CuriousTech/WiFiWaterbedHeater/README.md

# WiFi Smart Waterbed Heater

Discontinued years ago. Go here: [WiFiWaterbedHeater3](https://github.com/CuriousTech/WiFiWaterbedHeater3)

Original model:  
3D

SSR model:  
Slave2
