CuriousTech/WiFiWaterbedHeater/3D/WBFront.stl

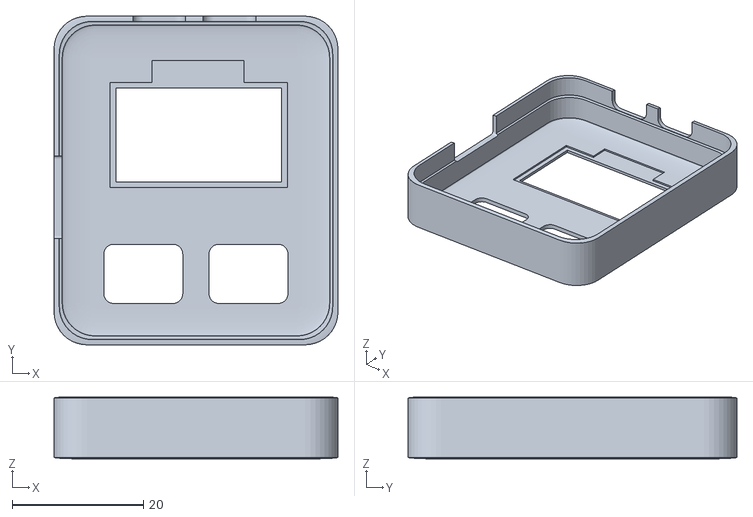
[picture p1: CAD file, 2018-10-15]
3D/WBFront.stl
43.2 x 50.0 x 9.41
