CuriousTech/WiFiWaterbedHeater/3D/WBbutton.stl

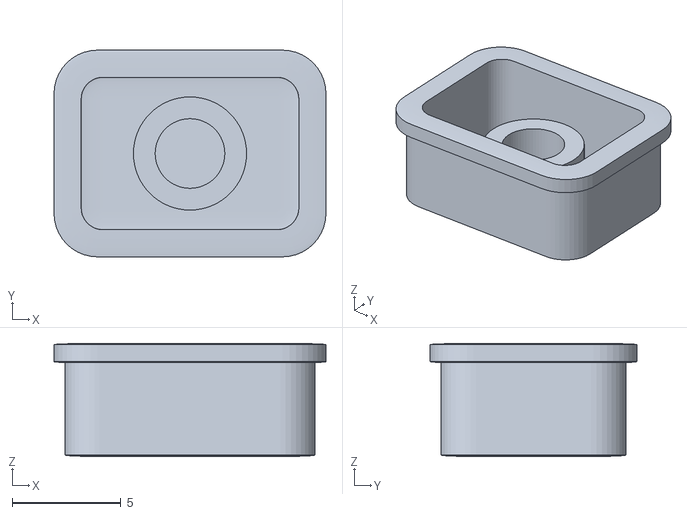
[picture p2: CAD file, 2018-10-15]
3D/WBbutton.stl
12.5 x 9.50 x 5.20
