CuriousTech/WiFiWaterbedHeater/3D/WBBack.stl

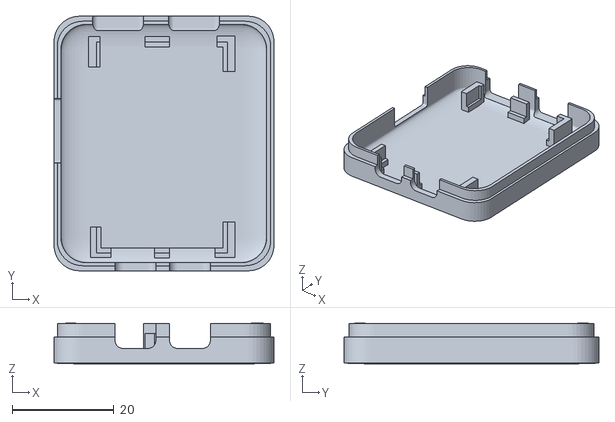
[picture p3: CAD file, 2018-10-13]
3D/WBBack.stl
43.2 x 50.0 x 7.96
