CuriousTech/WiFiWaterbedHeater/3D/Top_btn.stl

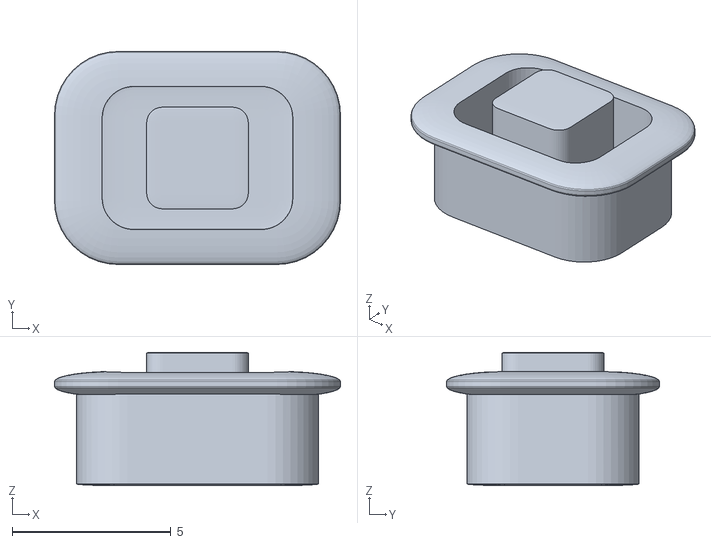
[picture p4: CAD file, 2018-10-13]
3D/Top_btn.stl
9.00 x 6.70 x 4.20
