CuriousTech/WiFiWaterbedHeater/3D/WBSlaveRlyTop.stl

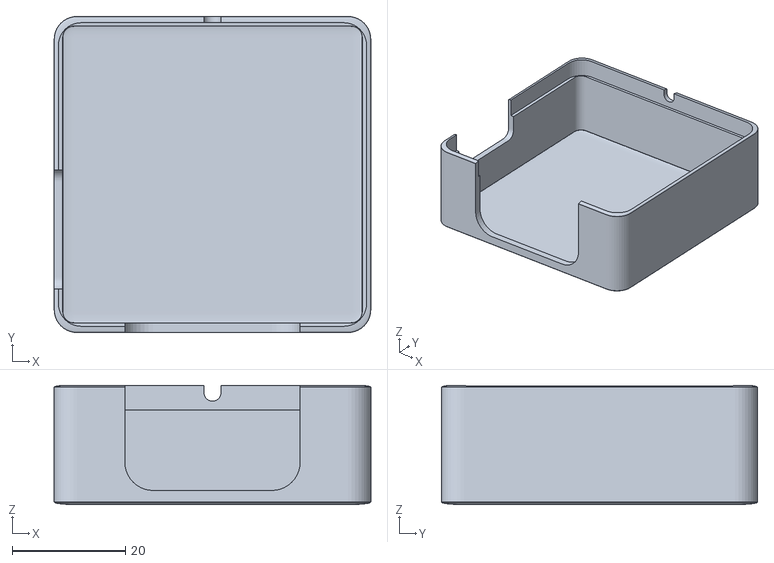
[picture p5: CAD file, 2018-09-26]
3D/WBSlaveRlyTop.stl
56.0 x 55.9 x 21.1
