CuriousTech/WiFiWaterbedHeater/3D/WBSlaveRlyBtm.stl

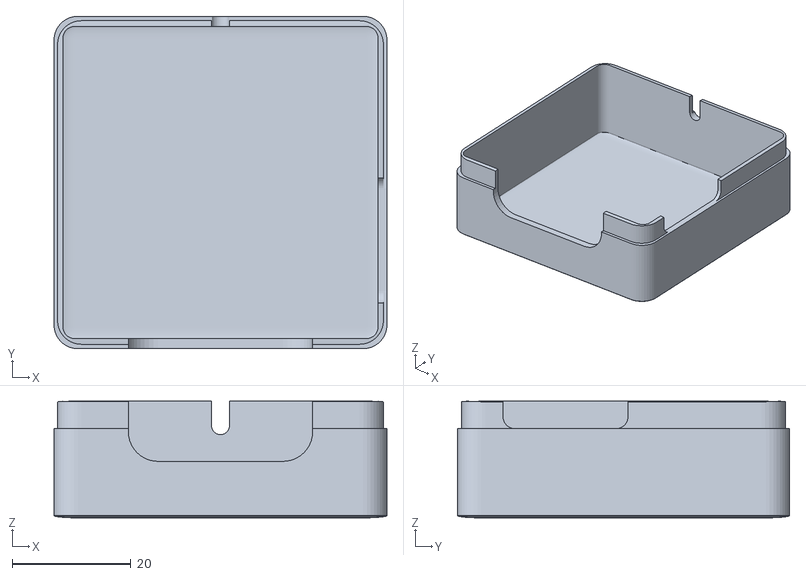
[picture p6: CAD file, 2018-09-26]
3D/WBSlaveRlyBtm.stl
56.0 x 55.9 x 19.6
