CuriousTech/WiFiWaterbedHeater/3D/Slave Bottom.stl

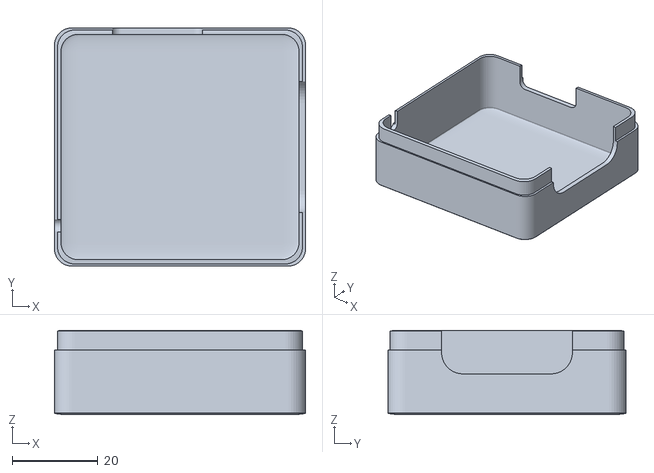
[picture p7: CAD file, 2018-07-28]
3D/Slave Bottom.stl
58.5 x 55.5 x 19.7
