CuriousTech/WiFiWaterbedHeater/3D/Slave Top.stl

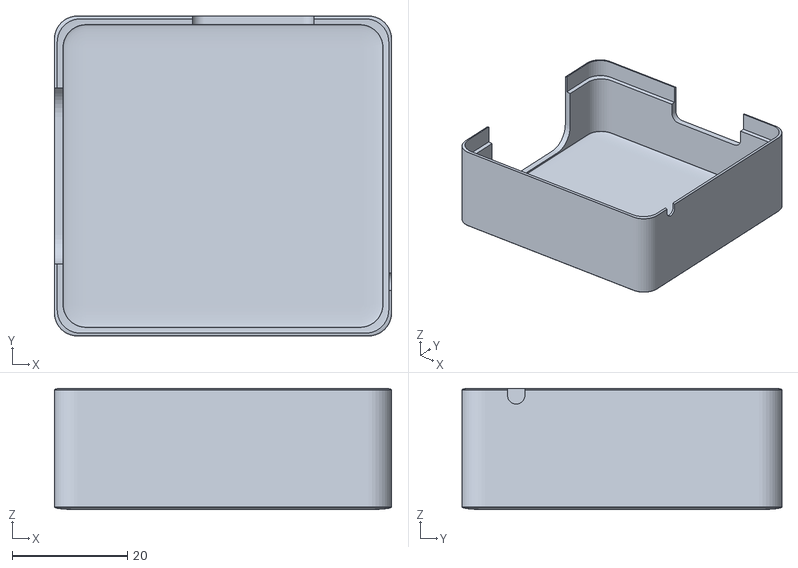
[picture p8: CAD file, 2018-07-28]
3D/Slave Top.stl
58.5 x 55.5 x 21.0
