CuriousTech/WiFiWaterbedHeater/Eagle/HeaterControl.brd

## EAGLE design Eagle/HeaterControl.brd (2018-10-13)

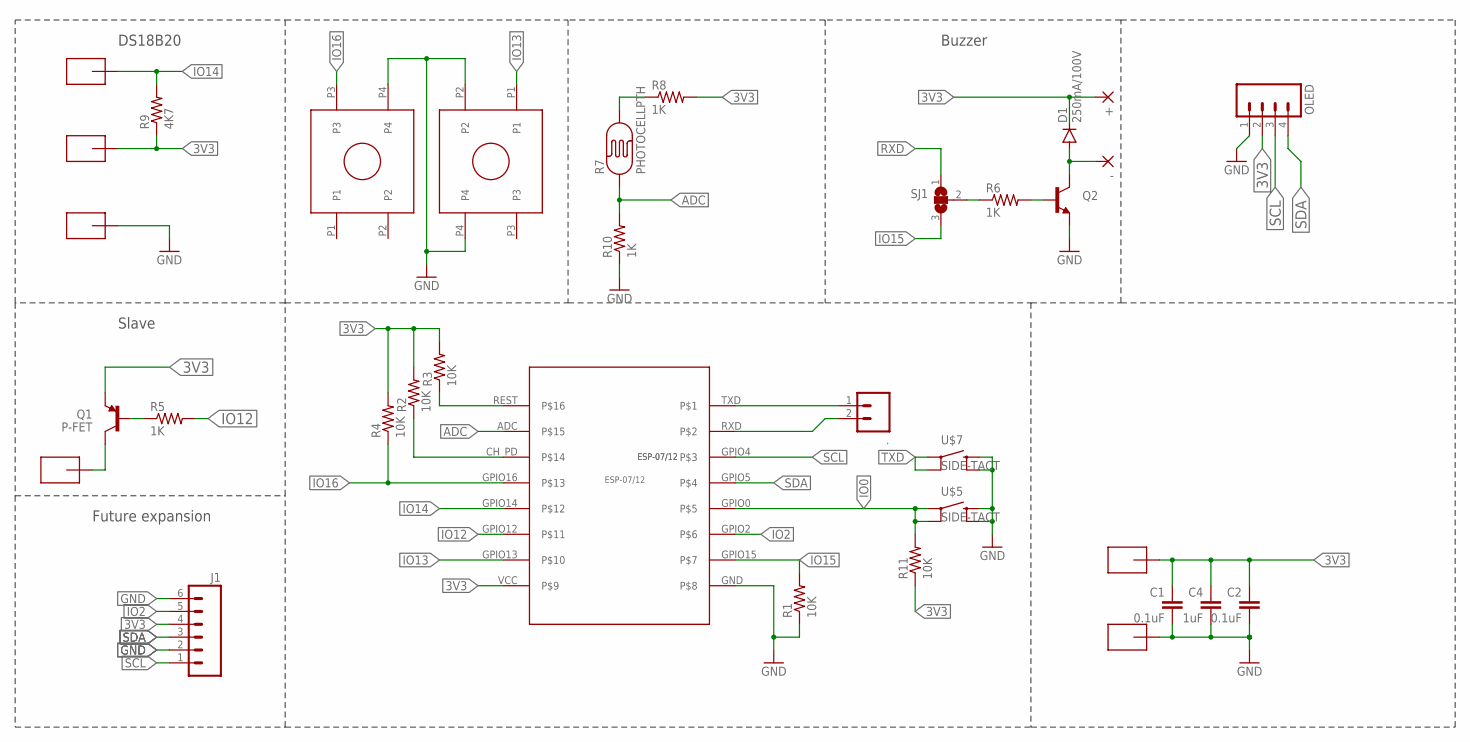
[picture p9: schematic HeaterControl.sch]

Parts:
+: 1,6/0,8
-: 1,6/0,8
.: M02PTH; 1X02
C1, C2: 0.1uF; 0805-CAP
C4: 1uF; 0805-CAP
D1: 250mA/100V; SOD-323
J1: M06SILK_FEMALE_PTH; 1X06
LEFT: OMROM_TH
OLED: M04PTH; 1X04
Q1: P-FET; SOT23-3
Q2: TRANSISTOR_NPNSOT23-3; SOT23-3
R1, R2, R3, R4, R11: 10K; 0805
R5, R6, R8, R10: 1K; 0805
R7: PHOTOCELLPTH; PHOTOCELL
R9: 4K7; 0805
RIGHT: OMROM_TH
SJ1: SJ2W; SJ_2
U$1: ESP-07/12
U$2, U$3, U$6, U$8, U$10, U$11: SMD-PAD1
U$5, U$7: SIDE-TACT

Connections:
3V3: +.1, C1.1, C2.1, C4.1, D1.C, J1.4, OLED.2, Q1.2 (E), R2.2, R3.2, R4.2, R8.2, R9.1, R11.1, U$1.VCC, U$3.>NAME, U$8.>NAME
ADC: R7.1, R10.2, U$1.ADC
GND: C1.2, C2.2, C4.2, J1.2, J1.6, LEFT.P4, OLED.1, Q2.2 (E), R1.1, R10.1, RIGHT.P2, RIGHT.P4, U$1.GND, U$5.3 (2), U$5.4, U$6.>NAME, U$7.3 (2), U$7.4, U$11.>NAME
IO0: R11.2, U$1.GPIO0, U$5.1, U$5.2 (3)
IO2: J1.5, U$1.GPIO2
IO12: R5.2, U$1.GPIO12
IO13: RIGHT.P1, U$1.GPIO13
IO14: R9.2, U$1.GPIO14, U$10.>NAME
IO15: R1.2, SJ1.3, U$1.GPIO15
IO16: LEFT.P3, R4.1, U$1.GPIO16
unnamed: Q1.3 (C), U$2.>NAME
unnamed: Q2.1 (B), R6.2
unnamed: -.1, D1.A, Q2.3 (C)
unnamed: R7.2, R8.1
unnamed: Q1.1 (B), R5.1
unnamed: R6.1, SJ1.2
unnamed: R2.1, U$1.CH_PD
REST: R3.1, U$1.REST
RXD: ..2, SJ1.1, U$1.RXD
SCL: J1.1, OLED.3, U$1.GPIO4
SDA: J1.3, OLED.4, U$1.GPIO5
TXD: ..1, U$1.TXD, U$7.1, U$7.2 (3)

Notes on the sheet:
DS18B20
Slave
Buzzer
Future expansion

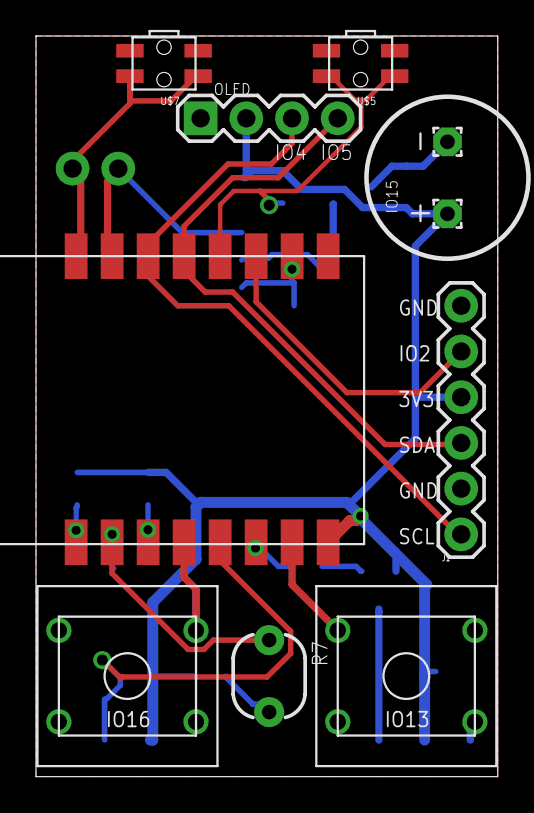
[picture p10: board HeaterControl.brd from above]

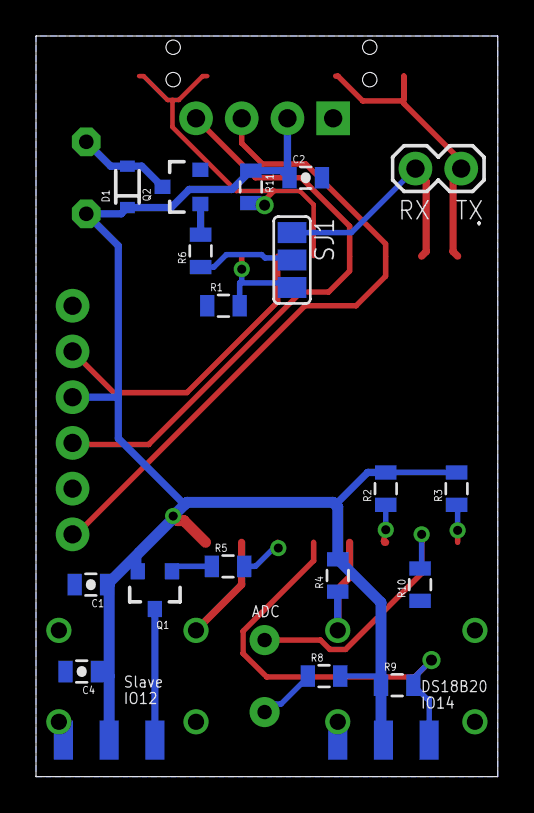
[picture p11: board HeaterControl.brd from below]

Board: 2 copper layers, 25.7 x 41.1 mm, 34 parts (24 on the bottom side), 22 nets.
