CuriousTech/WiFiWaterbedHeater/Slave/WaterbedSlave.brd

## EAGLE design Slave/WaterbedSlave.brd (2018-09-26)

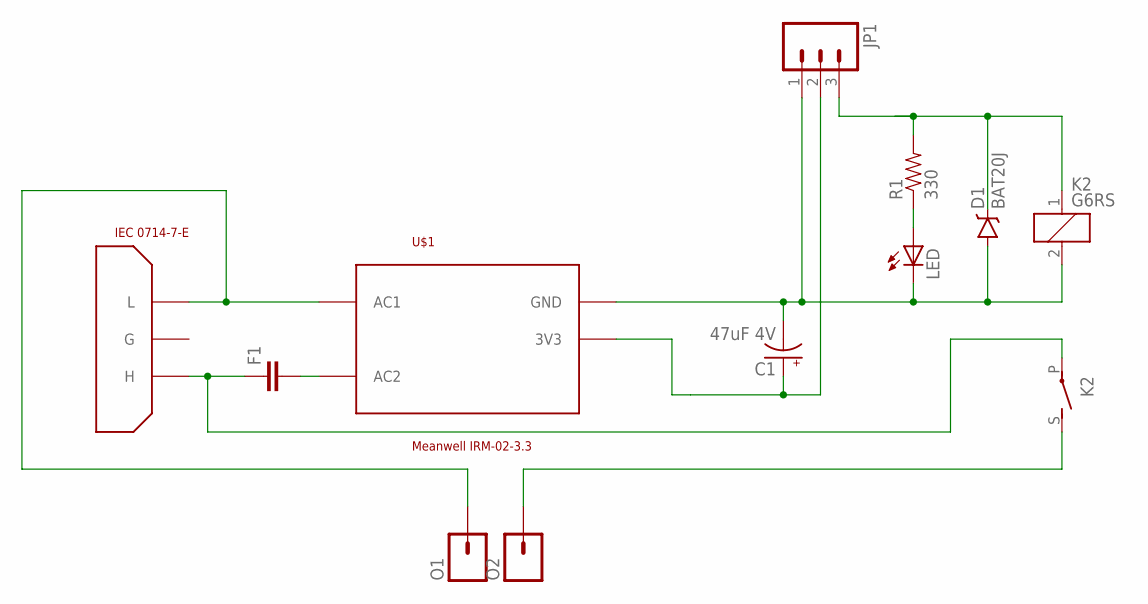
[picture p12: schematic WaterbedSlave.sch]

Parts:
C1: 47uF 4V; CPOL-RADIAL-10UF-25V
D1: BAT20J; SOD-323
F1: CAPPTH1; CAP-PTH-5MM
JP1: M03POLAR_LOCK; MOLEX-1X3_LOCK
K2: G6RS
LED: LEDCHIPLED_0805; CHIPLED_0805
O1, O2: M01PTH_2MM; 1X01_2MM
R1: 330; 0805
U$1: Meanwell IRM-02-3.3; RAC02-3.3SC
U$3: IEC 0714-7-E; IEC

Connections:
3V3: C1.1 (+), JP1.2, U$1.GND (3V3)
GND: C1.2 (-), D1.A, JP1.1, K2.2, LED.C, U$1.3V3 (GND)
unnamed: O1.1, U$1.AC1, U$3.L
unnamed: F1.2, U$1.AC2
unnamed: K2.S, O2.1
unnamed: F1.1, K2.P, U$3.H
unnamed: LED.A, R1.1
unnamed: D1.C, JP1.3, K2.1, R1.2

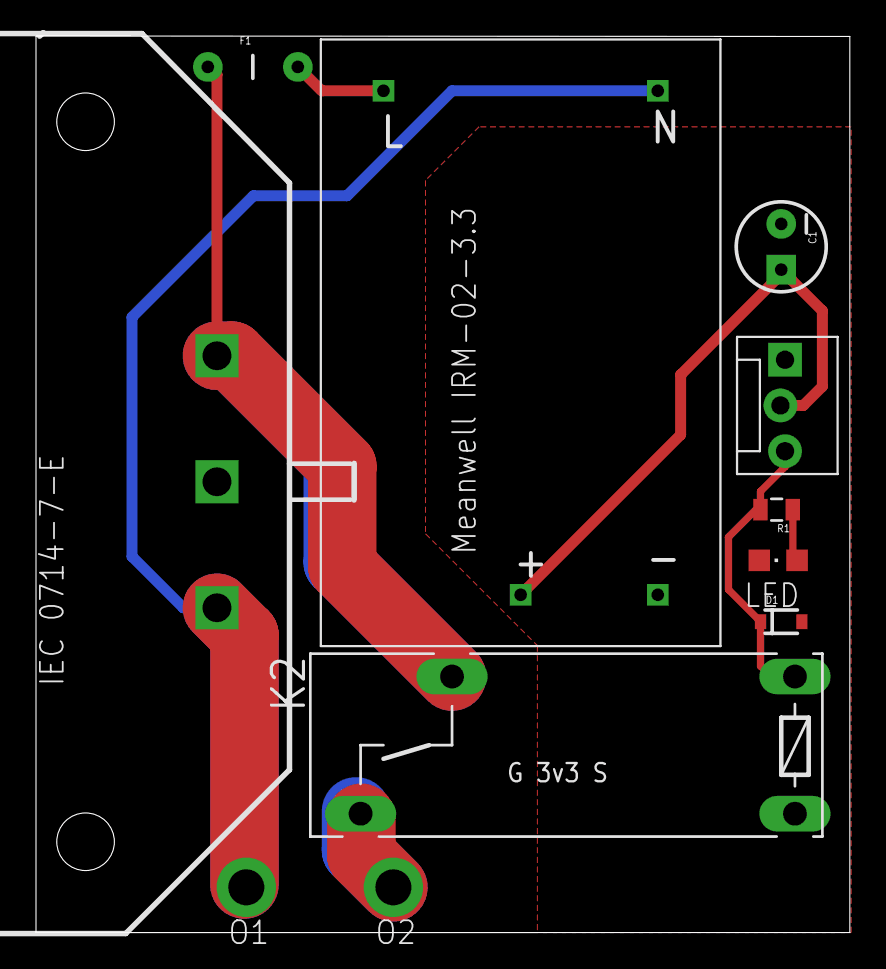
[picture p13: board WaterbedSlave.brd from above]

Board: 2 copper layers, 45.2 x 49.8 mm, 11 parts (0 on the bottom side), 8 nets.
