CuriousTech/WiFiWaterbedHeater/Eagle/HeaterControlPlusPIC.brd

## EAGLE design Eagle/HeaterControlPlusPIC.brd (2015-11-19)

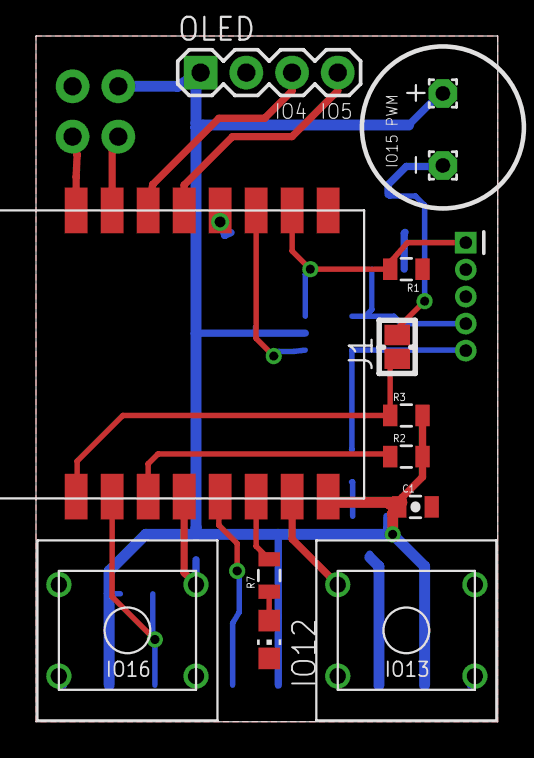
[picture p14: board HeaterControlPlusPIC.brd from above]

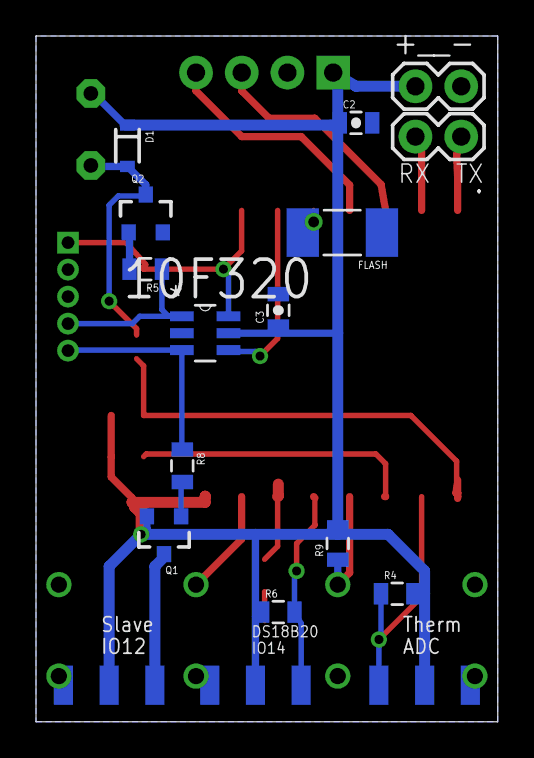
[picture p15: board HeaterControlPlusPIC.brd from below]

Board: 2 copper layers, 25.7 x 38.1 mm, 37 parts (23 on the bottom side), 23 nets.

Parts:
10F320: PIC10F320T-I/OT; SOT95P270X145-6N
+: 1,6/0,8
+__-: 1X02
-: 1,6/0,8
.: 1X02
C1, C2, C3: 0.1uF; 0805-CAP
D1: 250mA/100V; SOD-323
FLASH: BTN_4MM
IO12: CHIP-LED0805
J1: JUMPER_SOLDER_1X2
LEFT: OMROM_TH
OLED: 1X04
Q1: P-FET; SOT23-3
Q2: SOT23-3
R1, R2, R3, R4, R8, R9: 10K; 0805
R5: 1K; 0805
R6: 4K7; 0805
R7: 330; 0805
RIGHT: OMROM_TH
U$1: ESP-07/12
U$2, U$3, U$4, U$5, U$6, U$7, U$8, U$10, U$11: SMD-PAD1
U$9: PIC-ICSP-MINI

Connections:
3V3: 10F320.5, +.1, +__-.1, C1.1, C2.1, C3.1, D1.C, OLED.1, Q1.2, R2.2, R3.2, R4.2, R6.1, R9.2, U$1.VCC, U$3.>NAME, U$4.>NAME, U$8.>NAME
ADC: R4.1, U$1.ADC, U$7.>NAME
GND: 10F320.2, +__-.2, C1.2, C2.2, C3.2, FLASH.1, IO12.C, LEFT.P2, LEFT.P4, OLED.2, Q2.2, R1.1, RIGHT.P2, RIGHT.P4, U$1.GND, U$5.>NAME, U$6.>NAME, U$9.3, U$11.>NAME
HEAT: Q1.1, R8.2
ICSPCLK: 10F320.3, R8.1, U$9.5
IO0: FLASH.2, U$1.GPIO0
IO2: 10F320.4, U$1.GPIO2
IO12: R7.2, U$1.GPIO12
IO13: RIGHT.P1, U$1.GPIO13
IO14: R6.2, U$1.GPIO14, U$10.>NAME
IO15: 10F320.6, R1.2, U$1.GPIO15, U$9.1
IO16: LEFT.P3, R9.1, U$1.GPIO16
unnamed: Q1.3, U$2.>NAME
unnamed: Q2.1, R5.2
unnamed: OLED.3, U$1.GPIO4
unnamed: -.1, D1.A, J1.2, Q2.3
unnamed: IO12.A, R7.1
unnamed: OLED.4, U$1.GPIO5
unnamed: R2.1, U$1.CH_PD
PICPWM: 10F320.1, R5.1, U$9.4
REST: J1.1, R3.1, U$1.REST
RXD: ..2, U$1.RXD
TXD: ..1, U$1.TXD
