CuriousTech/WiFiWaterbedHeater/Adruino/WiFiHeater.ino

/**The MIT License (MIT)

Copyright (c) 2016 by Greg Cunningham, CuriousTech

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
THE SOFTWARE IS PROVIDED "AS IS", WITHOUT WARRANTY OF ANY KIND, EXPRESS OR
IMPLIED, INCLUDING BUT NOT LIMITED TO THE WARRANTIES OF MERCHANTABILITY,
FITNESS FOR A PARTICULAR PURPOSE AND NONINFRINGEMENT. IN NO EVENT SHALL THE
AUTHORS OR COPYRIGHT HOLDERS BE LIABLE FOR ANY CLAIM, DAMAGES OR OTHER
LIABILITY, WHETHER IN AN ACTION OF CONTRACT, TORT OR OTHERWISE, ARISING FROM,
OUT OF OR IN CONNECTION WITH THE SOFTWARE OR THE USE OR OTHER DEALINGS IN THE
SOFTWARE.
*/

#define SDEBUG
//uncomment to enable Arduino IDE Over The Air update code
#define OTA_ENABLE
//#define USE_SPIFFS

#include <Wire.h>
#include <ssd1306_i2c.h> // https://github.com/CuriousTech/WiFi_Doorbell/tree/master/Libraries/ssd1306_i2c
#include <EEPROM.h>
#include <ESP8266mDNS.h>
#include <ESPAsyncWebServer.h> // https://github.com/me-no-dev/ESPAsyncWebServer
#ifdef OTA_ENABLE
#include <FS.h>
#include <ArduinoOTA.h>
#endif
#ifdef USE_SPIFFS
#include <FS.h>
#include <SPIFFSEditor.h>
#else
#include "pages.h"
#endif
#include <OneWire.h>
#include <TimeLib.h> // http://www.pjrc.com/teensy/td_libs_Time.html
#include <UdpTime.h> // https://github.com/CuriousTech/ESP07_WiFiGarageDoor/tree/master/libraries/UdpTime
#include "eeMem.h"
#include "RunningMedian.h"
#include <JsonParse.h> // https://github.com/CuriousTech/ESP8266-HVAC/tree/master/Libraries/JsonParse
#include <AM2320.h> // https://github.com/CuriousTech/ESP8266-HVAC/tree/master/Libraries/AM2320
#include "jsonstring.h"

const char controlPassword[] = "password";    // device password for modifying any settings
const int serverPort = 80;                    // HTTP port
const char hostName[] = "Waterbed";

#define BTN_2     0 // right top
#define BTN_1     1 // left top
//#define MOTION_PIN 3  //
//#define VIBE      2
//#define ESP_LED   2  //Blue LED on ESP07 (on low)
#define SDA       4
#define SCL       5  // OLED and AM2320
#define HEAT     12  // Heater output
#define BTN_UP   13
#define DS18B20  14
#define TONE     15  // Speaker.  Beeps on powerup, but can also be controlled by aother IoT or add an alarm clock.
#define BTN_DN   16

OneWire ds(DS18B20);
byte ds_addr[8];
uint32_t lastIP;
int nWrongPass;

SSD1306 display(0x3C, SDA, SCL); // Initialize the oled display for address 0x3C, SDA=4, SCL=5 (is the OLED mislabelled?)
int displayOnTimer;
AM2320 am;
uint16_t light;
uint32_t nHeatCnt;
uint32_t nCoolCnt;
uint32_t nHeatETA;

bool bConfigDone = false;
bool bStarted = false;
uint32_t connectTimer;

eeMem ee;

AsyncWebServer server( serverPort );
AsyncWebSocket ws("/ws"); // access at ws://[esp ip]/ws

UdpTime utime;

bool bCF = false;
uint16_t roomTemp;
uint16_t rh;

int currentTemp = 860;
int hiTemp; // current target
int loTemp;
bool bHeater = false;
uint8_t schInd = 0;
String sMessage;
uint8_t msgCnt;
uint32_t onCounter;
bool bStartDisplay;
bool bMotion;

int toneFreq = 1000;
int tonePeriod = 100;
int toneCnt;

#ifdef VIBE
int vibePeriod = 200;
int vibeCnt;
#endif

struct tempArr{
  uint16_t min;
  uint16_t temp;
  uint8_t state;
  uint16_t rm;
  uint16_t rh;
};
#define LOG_CNT 98
tempArr tempArray[LOG_CNT];

void jsonCallback(int16_t iName, int iValue, char *psValue);
JsonParse jsonParse(jsonCallback);

const char days[7][4] = {"Sun","Mon","Tue","Wed","Thr","Fri","Sat"};
const char months[12][4] = {"Jan","Feb","Mar","Apr","May","Jun","Jul","Aug","Sep","Oct","Nov","Dec"};

bool updateAll(bool bForce)
{
  return ee.update(bForce);
}

String dataJson()
{
  jsonString js("state");

  js.Var("t", (uint32_t)(now() - ((ee.tz + utime.getDST()) * 3600)) );
  js.Var("waterTemp", String((float)currentTemp/10, 1) );
  js.Var("setTemp", String((float)ee.schedule[schInd].setTemp / 10, 1) );
  js.Var("hiTemp",  String((float)hiTemp/10, 1) );
  js.Var("loTemp",  String((float)loTemp/10, 1) );
  js.Var("on",   (digitalRead(HEAT)==LOW) ? 1:0 );
  js.Var("temp", String((float)roomTemp/10, 1) );
  js.Var("rh",   String((float)rh/10, 1) );
  js.Var("c",    String((bCF) ? "C":"F"));
  js.Var("mot",  bMotion);
  js.Var("eta",  nHeatETA);
  return js.Close();
}

String setJson() // settings
{
  jsonString js("set");

  js.Var("vt", String((float)ee.vacaTemp/10, 1) );
  js.Var("o",   ee.bEnableOLED);
  js.Var("tz",  ee.tz);
  js.Var("avg", ee.bAvg);
  js.Var("ppkwh",ee.ppkwh);
  js.Var("vo",  ee.bVaca);
  js.Var("idx", schInd);
  js.Var("cnt", ee.schedCnt);
  js.Var("w",  ee.watts);
  js.Var("r",  ee.rate);
  js.Var("e",  ee.bEco);
  js.Array("item", ee.schedule, 8);
  ee.tSecsMon[month()-1] += onCounter;
  onCounter = 0;
  js.Array("ts", ee.tSecsMon, 12);
  js.Array("ppkwm", ee.ppkwm, 12);
  return js.Close();
}

void ePrint(const char *s)
{
  jsonString js("print");
  js.Var("data", s);
  ws.textAll(js.Close());
}

void parseParams(AsyncWebServerRequest *request)
{
  char password[64];
  int16_t val;

 if(request->params() == 0)
    return;

  // get password first
  for ( uint8_t i = 0; i < request->params(); i++ ) {
    AsyncWebParameter* p = request->getParam(i);
    String s = request->urlDecode(p->value());

    switch( p->name().charAt(0)  )
    {
      case 'k': // key
        s.toCharArray(password, sizeof(password));
        break;
    }
  }

  uint32_t ip = request->client()->remoteIP();

  if(strcmp(controlPassword, password) || nWrongPass)
  {
    if(nWrongPass == 0)
      nWrongPass = 10;
    else if((nWrongPass & 0xFFFFF000) == 0 ) // time doubles for every high speed wrong password attempt.  Max 1 hour
      nWrongPass <<= 1;
    if(ip != lastIP)  // if different IP drop it down
       nWrongPass = 10;

    jsonString js("hack");
    js.Var("ip", request->client()->remoteIP().toString() );
    js.Var("pass", password);
    ws.textAll(js.Close());
    lastIP = ip;
    return;
  }

  lastIP = ip;

  for ( uint8_t i = 0; i < request->params(); i++ ) {
    AsyncWebParameter* p = request->getParam(i);
    String s = request->urlDecode(p->value());

    int which = p->name().charAt(1) - '0'; // limitation = 9
    if(which >= MAX_SCHED) which = MAX_SCHED - 1; // safety
    val = s.toInt();

    switch( p->name().charAt(0)  )
    {
      case 'm':  // message
        sMessage = s;
        sMessage += " ";
        msgCnt = 4;
        if(ee.bEnableOLED == false)
        {
          bStartDisplay = true;
          displayOnTimer = 60;
        }
        break;
      case 'r': // rate
        if(val == 0)
          break; // don't allow 0
        ee.rate = val;
        sendState();
        break;
      case 'a':
        updateAll(true);
        delay(100);
        ESP.reset();
        break;
      case 'b': // beep : /s?key=pass&b=1000,800,3 (tone or ms,tone,cnt)
        toneCnt = 1;
        {
          int n = s.indexOf(",");
          if(n >0)
          {
            tonePeriod = constrain(val, 10, 1000);
            s.remove(0, n+1);
            val = s.toInt();
          }
          toneFreq = val;
          n = s.indexOf(",");
          if(n >0)
          {
            s.remove(0, n+1);
            toneCnt = constrain(s.toInt(), 1, 20);
          }
        }
        break;
      case 'c': // restore the month's total (in cents) after updates
        break;
      case 'w': // restore the month's total (in watthours) after updates
        break;
#ifdef VIBE
      case 'v': // vibe
        {
          int n = s.indexOf(",");
          if(n >0)
          {
            s.remove(0, n+1);
            vibeCnt = s.toInt();
          }
        }
        vibePeriod = val;
        pinMode(VIBE, OUTPUT);
        digitalWrite(VIBE, LOW);
        break;
#endif
      case 't': // tadj (for room temp)
        ee.tAdj[1] = constrain(val, -200, 200);
        break;
    }
  }
}

String sDec(int t) // just 123 to 12.3 string
{
  String s = String( t / 10 ) + ".";
  s += t % 10;
  return s;
}

// Time in hh:mm[:ss][AM/PM]
String timeFmt(bool do_sec, bool do_M)
{
  String r = "";
  if(hourFormat12() < 10) r = " ";
  r += hourFormat12();
  r += ":";
  if(minute() < 10) r += "0";
  r += minute();
  if(do_sec)
  {
    r += ":";
    if(second() < 10) r += "0";
    r += second();
    r += " ";
  }
  if(do_M)
  {
      r += isPM() ? "PM":"AM";
  }
  return r;
}

void handleS(AsyncWebServerRequest *request) { // standard params, but no page
  parseParams(request);

  jsonString js;
  String s = WiFi.localIP().toString() + ":";
  s += serverPort;
  js.Var("ip", s);
  request->send ( 200, "text/json", js.Close() );
}

const char *jsonListCmd[] = {
  "key",
  "oled",
  "TZ",
  "avg",
  "cnt",
  "tadj", // 5
  "ppkwh",
  "vaca",
  "vacatemp",
  "I",
  "N", // 10
  "S",
  "T",
  "H",
  "beepF",
  "beepP", // 15
  "vibe",
  "watts",
  "dot",
  "save",
  "aadj", // 20
  "eco",
  NULL
};

bool bKeyGood;

void jsonCallback(int16_t iName, int iValue, char *psValue)
{
  if(!bKeyGood && iName) return; // only allow for key
  char *p, *p2;
  static int beepPer = 1000;
  static int item = 0;

  switch(iName)
  {
    case 0: // key
      if(!strcmp(psValue, controlPassword)) // first item must be key
        bKeyGood = true;
      break;
    case 1: // OLED
      if( ee.bEnableOLED == false && iValue)
        bStartDisplay = true;
      ee.bEnableOLED = iValue ? true:false;
      break;
    case 2: // TZ
      ee.tz = iValue;
      utime.start();
      break;
    case 3: // avg
      ee.bAvg = iValue;
      break;
    case 4: // cnt
      ee.schedCnt = constrain(iValue, 1, 8);
      ws.textAll(setJson()); // update all the entries
      break;
    case 5: // tadj
      changeTemp(iValue, false);
      ws.textAll(setJson()); // update all the entries
      break;
    case 6: // ppkw
      ee.ppkwm[month()-1] = ee.ppkwh = iValue;
      break;
    case 7: // vaca
      ee.bVaca = iValue;
      break;
    case 8: // vacatemp
      if(bCF)
        ee.vacaTemp = constrain( (int)(atof(psValue)*10), 100, 290); // 10-29C
      else
        ee.vacaTemp = constrain( (int)(atof(psValue)*10), 600, 840); // 60-84F
      break;
    case 9: // I
      item = iValue;
      break;
    case 10: // N
      strncpy(ee.schedule[item].name, psValue, sizeof(ee.schedule[0].name) );
      break;
    case 11: // S
      p = strtok(psValue, ":");
      p2 = strtok(NULL, "");
      if(p && p2){
        iValue *= 60;
        iValue += atoi(p2);
      }
      ee.schedule[item].timeSch = iValue;
      break;
    case 12: // T
      ee.schedule[item].setTemp = atof(psValue)*10;
      break;
    case 13: // H
      ee.schedule[item].thresh = (int)(atof(psValue)*10);
      checkLimits();      // constrain and check new values
      checkSched(true);   // reconfigure to new schedule
      break;
   case 14: // beepF
      toneCnt = 1;
      toneFreq = iValue;
      break;
   case 15: // beepP (beep period)
      tonePeriod = iValue;
      toneCnt = 1;
      break;
   case 16: // vibe (vibe period)
#ifdef VIBE
      vibePeriod = iValue;
      vibeCnt = 1;
      pinMode(VIBE, OUTPUT);
      digitalWrite(VIBE, LOW);
#endif
      break;
    case 17: // watts
      ee.watts = iValue;
      break;
    case 18: // dot displayOnTimer
      if((displayOnTimer == 0) && (ee.bEnableOLED == false) && iValue)
      {
        bStartDisplay = true;
      }
      displayOnTimer = iValue;
      break;
    case 19: // save
      updateAll(true);
      break;
    case 20: // aadj
      changeTemp(iValue, true);
      ws.textAll(setJson()); // update all the entries
      break;
    case 21: // eco
      ee.bEco = iValue ? true:false;
      setHeat();
      break;
  }
}

void onWsEvent(AsyncWebSocket * server, AsyncWebSocketClient * client, AwsEventType type, void * arg, uint8_t *data, size_t len)
{  //Handle WebSocket event
  static bool bRestarted = true;

  switch(type)
  {
    case WS_EVT_CONNECT:      //client connected
      if(bRestarted)
      {
        bRestarted = false;
        jsonString js("alert");
        js.Var("data", "Restarted");
        client->text(js.Close());
      }
      client->text(dataJson());
      client->text(setJson());
      client->ping();
      break;
    case WS_EVT_DISCONNECT:    //client disconnected
      break;
    case WS_EVT_ERROR:    //error was received from the other end
      break;
    case WS_EVT_PONG:    //pong message was received (in response to a ping request maybe)
      break;
    case WS_EVT_DATA:  //data packet
      AwsFrameInfo * info = (AwsFrameInfo*)arg;
      if(info->final && info->index == 0 && info->len == len){
        //the whole message is in a single frame and we got all of it's data
        if(info->opcode == WS_TEXT){
          data[len] = 0;

          bKeyGood = false; // for callback (all commands need a key)
          jsonParse.process((char*)data);
          ws.textAll(setJson()); // update the page settings
        }
      }
      break;
  }
}

void setup()
{
  pinMode(HEAT, OUTPUT);
  digitalWrite(HEAT, HIGH); // high is off
#ifdef SDEBUG
  Serial.begin(115200);
  delay(100);
  Serial.println();
  Serial.println("Starting");
#else
  pinMode(BTN_1, INPUT_PULLUP);
#endif

#ifdef MOTION_PIN
  pinMode(MOTION_PIN, INPUT);
#endif
  pinMode(BTN_2, INPUT);  // IO0 needs external WPU
  pinMode(TONE, OUTPUT);
  digitalWrite(TONE, LOW);
  pinMode(BTN_UP, INPUT_PULLUP);
  pinMode(BTN_DN, INPUT); // IO16 has external pullup

  // initialize dispaly
  display.init();
  display.flipScreenVertically();

  WiFi.hostname(hostName);
  WiFi.mode(WIFI_STA);

  if ( ee.szSSID[0] )
  {
    WiFi.begin(ee.szSSID, ee.szSSIDPassword);
    WiFi.setHostname(hostName);
    bConfigDone = true;
  }
  else
  {
    Serial.println("No SSID. Waiting for EspTouch.");
    WiFi.beginSmartConfig();
  }
  connectTimer = now();

#ifdef USE_SPIFFS
  SPIFFS.begin();
  server.addHandler(new SPIFFSEditor("admin", controlPassword));
#endif

  // attach AsyncWebSocket
  ws.onEvent(onWsEvent);
  server.addHandler(&ws);

  server.on ( "/", HTTP_GET, [](AsyncWebServerRequest *request)
  {
//    if(wifi.isCfg())
//      request->send( 200, "text/html", wifi.page() ); // WIFI config page
//    else
    {
      parseParams(request);
      #ifdef USE_SPIFFS
        request->send(SPIFFS, "/index.htm");
      #else
        request->send_P(200, "text/html", index_page);
      #endif
    }
  });
  server.on ( "/s", HTTP_GET | HTTP_POST, handleS );
  server.on ( "/set", HTTP_GET, [](AsyncWebServerRequest *request){
    request->send( 200, "text/json", setJson() );
  });
  server.on ( "/json", HTTP_GET, [](AsyncWebServerRequest *request){
    request->send( 200, "text/json", dataJson() );
  });

  server.onNotFound([](AsyncWebServerRequest *request){ // be silent
//    request->send(404);
  });
  server.on("/heap", HTTP_GET, [](AsyncWebServerRequest *request){
    request->send(200, "text/plain", String(ESP.getFreeHeap()));
  });
  server.on("/scan", HTTP_GET, [](AsyncWebServerRequest *request){
    String json = "[";
    int n = WiFi.scanComplete();
    if(n == -2){
      WiFi.scanNetworks(true);
    } else if(n){
      for (int i = 0; i < n; ++i){
        if(i) json += ",";
        jsonString js;

        js.Var("rssi", String(WiFi.RSSI(i)) );
        js.Var("ssid", WiFi.SSID(i) );
        js.Var("bssid", WiFi.BSSIDstr(i) );
        js.Var("channel", String(WiFi.channel(i)) );
        js.Var("secure", String(WiFi.encryptionType(i)) );
        js.Var("hidden", String(WiFi.isHidden(i)?"true":"false") );
        json += js.Close();
      }
      WiFi.scanDelete();
      if(WiFi.scanComplete() == -2)
        WiFi.scanNetworks(true);
    }
    json += "]";
    request->send(200, "text/json", json);
  });
  server.on("/data", HTTP_GET, [](AsyncWebServerRequest *request){
    String json = "tdata=[";
    bool bSent = false;
    for (int i = 0; i <= 96; ++i){
      if(tempArray[i].state == 2) // now
      {
        tempArray[i].min = (hour()*60) + minute();
        tempArray[i].temp = currentTemp;
        tempArray[i].rm = roomTemp;
        tempArray[i].rh = rh;
      }
      if(tempArray[i].temp) // only send entries in use (hitting a limit when SSL is compiled in)
      {
        if(bSent) json += ",";
        jsonString js;
        js.Var("tm", tempArray[i].min );
        js.Var("t", String(sDec(tempArray[i].temp)) );
        js.Var("s", tempArray[i].state );
        js.Var("rm", String( sDec(tempArray[i].rm) ) );
        js.Var("rh", String( sDec(tempArray[i].rh) ) );
        json += js.Close();
        bSent = true;
      }
    }
    json += "]";
    request->send(200, "text/json", json);
  });

  server.on("/favicon.ico", HTTP_GET, [](AsyncWebServerRequest *request){
#ifdef USE_SPIFFS
      request->send(SPIFFS, "/favicon.ico");
#else
    AsyncWebServerResponse *response = request->beginResponse_P(200, "image/x-icon", favicon, sizeof(favicon));
    response->addHeader("Content-Encoding", "gzip");
    request->send(response);
#endif
  });

  server.onFileUpload([](AsyncWebServerRequest *request, String filename, size_t index, uint8_t *data, size_t len, bool final){
  });
  server.onRequestBody([](AsyncWebServerRequest *request, uint8_t *data, size_t len, size_t index, size_t total){
  });
  server.begin();

#ifdef OTA_ENABLE
  ArduinoOTA.setHostname(hostName);
  ArduinoOTA.begin();
  ArduinoOTA.onStart([]() {
    digitalWrite(HEAT, HIGH);
    ee.tSecsMon[month()-1] += onCounter;
    updateAll( true );
  });
#endif
  jsonParse.setList(jsonListCmd);

  if( ds.search(ds_addr) )
  {
 #ifdef SDEBUG
    Serial.print("OneWire device: "); // 28 22 92 29 7 0 0 6B
    for( int i = 0; i < 8; i++) {
      Serial.print(ds_addr[i], HEX);
      Serial.print(" ");
    }
    Serial.println("");
    if( OneWire::crc8( ds_addr, 7) != ds_addr[7]){
      Serial.println("Invalid CRC");
    }
 #endif
  }
  else
  {
#ifdef SDEBUG
    Serial.println("No OneWire devices");
 #endif
  }

  am.begin(SDA, SCL);
  Tone(2600, 200);
  bStartDisplay = ee.bEnableOLED;
}

uint8_t ssCnt = 30;
uint8_t motCnt;

void loop()
{
  static RunningMedian<uint16_t,24> tempMedian[2];
  static uint8_t min_save, sec_save, mon_save = 0;
  static bool bLastOn;

  MDNS.update();
#ifdef OTA_ENABLE
  ArduinoOTA.handle();
#endif
  checkButtons();

  if(toneCnt)
  {
    Tone(toneFreq, tonePeriod);
    if(--toneCnt)
      delay(tonePeriod);
  }

#ifdef VIBE
  if(vibeCnt)
  {
    delay(vibePeriod);
    pinMode(VIBE, INPUT);
    digitalWrite(VIBE, HIGH);
    if(--vibeCnt)
    {
      pinMode(VIBE, OUTPUT);
      digitalWrite(VIBE, LOW);
    }
  }
#endif

#ifdef MOTION_PIN
  if(digitalRead(MOTION_PIN) != bMotion)
  {
    bMotion = digitalRead(MOTION_PIN);
    if(bMotion)
    {
      sendState();
      if(ee.bEnableOLED == false && displayOnTimer == 0)
        bStartDisplay = true;
      displayOnTimer = 60;
    }
  }
#endif

  if(bStartDisplay)
  {
    bStartDisplay = false;
    display.init();
    display.flipScreenVertically();
  }

  if(sec_save != second()) // only do stuff once per second
  {
    sec_save = second();

    if(!bConfigDone)
    {
      if( WiFi.smartConfigDone())
      {
        Serial.println("SmartConfig set");
        bConfigDone = true;
        connectTimer = now();
      }
    }
    if(bConfigDone)
    {
      if(WiFi.status() == WL_CONNECTED)
      {
        if(!bStarted)
        {
          Serial.println("WiFi Connected");
          MDNS.begin( hostName );
          bStarted = true;
          utime.start();
          MDNS.addService("iot", "tcp", serverPort);
          WiFi.SSID().toCharArray(ee.szSSID, sizeof(ee.szSSID)); // Get the SSID from SmartConfig or last used
          WiFi.psk().toCharArray(ee.szSSIDPassword, sizeof(ee.szSSIDPassword) );
          updateAll(false);
        }
        if(utime.check(ee.tz))
          checkSched(true);  // initialize
      }
      else if(now() - connectTimer > 10) // failed to connect for some reason
      {
        Serial.println("Connect failed. Starting SmartConfig");
        connectTimer = now();
        ee.szSSID[0] = 0;
        WiFi.mode(WIFI_AP_STA);
        WiFi.beginSmartConfig();
        bConfigDone = false;
        bStarted = false;
      }
    }

    checkTemp();
/*    static uint8_t am_cnt = 5;
    if(--am_cnt == 0)
    {
      am_cnt = 30;

    }
*/
    if(--ssCnt == 0)
       sendState();

    if(min_save != minute()) // only do stuff once per minute
    {
      min_save = minute();
      checkSched(false);     // check every minute for next schedule
      if( min_save == 0)     // update clock daily (at 2AM for DST)
      {
        if( hour() == 2)
        {
          utime.start();
          updateAll(true);      // update EEPROM daily
        }
        if( mon_save != month() )
        {
          mon_save = month();
          ee.tSecsMon[mon_save-1] = 0;
        }
        addLog();
        if( updateAll(false) )      // update EEPROM if changed
          ws.textAll("print;EEPROM updated");
      }
      if(min_save == 30)
        addLog(); // half hour log

      float temp2, rh2;

      if(am.measure(temp2, rh2))
      {
        float newtemp, newrh;

        if(bCF == false)
          temp2 = (1.8 * temp2 + 32.0);
        temp2 *= 10;
        temp2 += ee.tAdj[1]; // calibrated temp value
        tempMedian[0].add( temp2 );
        tempMedian[0].getAverage(2, newtemp);
        tempMedian[1].add(rh2 * 10);
        tempMedian[1].getAverage(2, newrh);
        if(roomTemp != newtemp)
        {
          roomTemp = newtemp;
          rh = newrh;
          sendState();
        }
      }
    }

    if(displayOnTimer) displayOnTimer --;
    if(nWrongPass)    nWrongPass--;
    if(digitalRead(HEAT) == LOW)
      onCounter++;
    else if(onCounter)
    {
      ee.tSecsMon[month()-1] += onCounter;
      onCounter = 0;
    }

    if(bHeater)
      nHeatCnt++;
    else
      nCoolCnt++;
    if(nHeatETA)
      nHeatETA--;

    static uint16_t s = 1;
    if(ee.bEco && bHeater) // eco mode
    {
      bool bBoost = (currentTemp < loTemp - ee.pids[2]); // 0.5 deg diff
      if(bBoost == false)
      {
        if(--s == 0)
        {
          bool bOff = digitalRead(HEAT);
          s = (bOff) ? ee.pids[1] : ee.pids[0]; // off 60 secs /on 180 secs (75%)
          digitalWrite(HEAT, !bOff);
        }
      }
    }

    if(bHeater != bLastOn || onCounter > (60*60*12)) // total up when it turns off or before 32 bit carry error
    {
      ee.tSecsMon[month()-1] += onCounter;
      onCounter = 0;
      if(bLastOn)
        updateAll( false );
      bLastOn = bHeater;
    }
  }

  if(WiFi.status() != WL_CONNECTED)
    return;
 
  // Draw screen
  static bool blnk;
  static long last;

  // draw the screen here
  display.clear();

  if(ee.bEnableOLED == false && displayOnTimer == 0)
  {
    if(bHeater)  // small strobe dot when display is off
    {  if(second() != last)
      {
        display.drawString( (second()<<1) + (minute()&1), minute()%30, ".");
        last = second();
      }
    }
    display.display();
    return;
  }

  String s;

  if(sMessage.length()) // message sent over wifi
  {
    s = sMessage; // custom message
    if(msgCnt == 0) // starting
      msgCnt = 3; // times to repeat message
  }
  else
  {
    s = timeFmt(true, true); // the default scroller
    s += "  ";
    s += days[weekday()-1]; s += " ";
    s += String(day()); s += " ";
    s += months[month()-1]; s += "  ";
    s += sDec(roomTemp); s += "]F "; // <- that's a degree symbol
    s += sDec(rh); s += "% ";
  }

  Scroller(s);
  static uint16_t x[2] = {0, 64};

  if(minute()&1)
    x[0] = 64, x[1] = 0;
  else
    x[0] = 0, x[1] = 64;

  display.setFontScale2x2(false); // the small text
  display.drawString(x[0]+ 9, 22, "Temp");
  display.drawString(x[1]+19, 22, "Set");
  const char *ps = ee.bVaca ? "Vacation" : ee.schedule[schInd].name;
  display.drawString(x[1]+32-(strlen(ps) << 2), 55, ps);

  String temp = sDec(currentTemp) + "]"; // <- that's a degree symbol
  display.drawPropString(x[0]+2, 33, temp );
  temp = sDec( hiTemp ) + "]";
  display.drawPropString(x[1]+10, 33, temp );

  if(bHeater)
  {
    if( (millis() - last) > 400) // 400ms toggle for blinker
    {
      last = millis();
      blnk = !blnk;
    }
    if(blnk)
      display.drawString(x[0]+1, 55, "Heat");
  }
  display.display();
}

void addLog()
{
  int iPos = hour() << 2; //+ ( minute() / 15); // 4 per hour
  if( minute() ) // force 1 and 3 slots
  {
    if(minute() < 30)
      iPos ++;
    else if(minute() == 30)
      iPos += 2;
    else
      iPos += 3;
  }
  if(iPos == 0) //fill in to 24:00
  {
    if(tempArray[95].state == 2)
      memset(&tempArray[95], 0, sizeof(tempArr));
    tempArray[96].min = 24*60;
    tempArray[96].temp = currentTemp;
    tempArray[96].state = bHeater;
    tempArray[96].rm = roomTemp;
    tempArray[96].rh = rh;
  }
  tempArray[iPos].min = (hour() * 60) + minute();
  tempArray[iPos].temp = currentTemp;
  tempArray[iPos].state = bHeater;
  tempArray[iPos].rm = roomTemp;
  tempArray[iPos].rh = rh;

  if(iPos)
    if(tempArray[iPos-1].state == 2)
      memset(&tempArray[iPos-1], 0, sizeof(tempArr));

  tempArray[iPos+1].temp = currentTemp;
  tempArray[iPos+1].state = 2;  // use 2 as a break between old and new
}

// Text scroller optimized for very long lines
void Scroller(String s)
{
  static int16_t ind = 0;
  static char last = 0;
  static int16_t x = 0;

  if(last != s.charAt(0)) // reset if content changed
  {
    x = 0;
    ind = 0;
  }
  last = s.charAt(0);
  int len = s.length(); // get length before overlap added
  s += s.substring(0, 18); // add ~screen width overlap
  int w = display.propCharWidth(s.charAt(ind)); // measure first char
  if(w > 100) w = 10; // bug in function (0 returns 11637)
  String sPart = s.substring(ind, ind + 18);
  display.drawPropString(x, 0, sPart );

  if( --x <= -(w))
  {
    x = 0;
    if(++ind >= len) // reset at last char
    {
      ind = 0;
      if(msgCnt) // end of custom message display
      {
        if(--msgCnt == 0) // decrement times to repeat it
            sMessage = String();
      }
    }
  }
}

void setHeat()
{
  digitalWrite(HEAT, !bHeater);
}

// Check temp to turn heater on and off
void checkTemp()
{
  static RunningMedian<uint16_t,32> tempMedian;
  static RunningMedian<uint32_t,8> heatTimeMedian;
//  static RunningMedian<uint32_t,8> coolTimeMedian;
  static uint8_t state = 0;

  switch(state)
  {
    case 0: // start a conversion
      ds.reset();
      ds.select(ds_addr);
      ds.write(0x44, 0);   // start conversion, no parasite power on at the end
      state++;
      return;
    case 1:
      state++;
      break;
    case 2:
      state = 0; // 1 second rest
      return;
  }

  uint8_t data[10];
  uint8_t present = ds.reset();
  ds.select(ds_addr);
  ds.write(0xBE);         // Read Scratchpad

  if(!present)      // safety
  {
    bHeater = false;
    setHeat();
    return;
  }

  for ( int i = 0; i < 9; i++)          // we need 9 bytes
    data[i] = ds.read();

  if(OneWire::crc8( data, 8) != data[8])  // bad CRC
  {
    bHeater = false;
    setHeat();
    return;
  }

  uint16_t raw = (data[1] << 8) | data[0];

  if(raw > 630 || raw < 200){ // first reading is always 1360 (0x550)
    jsonString js("alert");
    js.Var("data", "DS error");
    ws.textAll(js.Close());
    return;
  }

  if(bCF)
    tempMedian.add(( raw * 625) / 1000 );  // to 10x celcius
  else
    tempMedian.add( (raw * 1125) / 1000 + 320) ; // 10x fahrenheit

  float t;
  tempMedian.getAverage(2, t);
  uint16_t newTemp = t;

  static uint16_t oldHT;
  if(newTemp != currentTemp || hiTemp != oldHT)
  {
    if(currentTemp != newTemp && currentTemp)
    {
      if(bHeater)
      {
        int16_t chg = newTemp - currentTemp;
        uint16_t tDiff = hiTemp - newTemp;
        if(nHeatCnt > 500 && chg > 0)
        {
          heatTimeMedian.add(nHeatCnt);
          float fCt;
          heatTimeMedian.getAverage(fCt);
          uint32_t ct = fCt;
          nHeatETA = ct * tDiff;
          nHeatCnt = 0;
        }
      }
      else
      {
/*
        int16_t chg = currentTemp - newTemp;
        uint16_t tDiff = newTemp - loTemp;
        if(nCoolCnt > 500 && chg > 0)
        {
          coolTimeMedian.add(nCoolCnt);
          float fCt;
          coolTimeMedian.getAverage(fCt);
          uint32_t ct = fCt;
          uint32_t eta = ct * tDiff;
          nCoolCnt = 0;
        }
*/
      }
    }
    currentTemp = newTemp;
    oldHT = hiTemp;
    sendState();
  }

  if(currentTemp <= loTemp && bHeater == false)
  {
    bHeater = true;
    setHeat();
    sendState();
    addLog();
  }
  else if(currentTemp >= hiTemp && bHeater == true)
  {
    bHeater = false;
    nHeatETA = 0;
    setHeat();
    sendState();
    addLog();
  }
}

String timeFmt(uint32_t v)
{
  String s;
  uint32_t m = v / 60;
  uint8_t h = m / 60;
  m %= 60;
  v %= 60;
  s += h;
  s += ":";
  if(m < 10) s += "0";
  s += m;
  s += ":";
  if(v < 10) s += "0";
  s += v;
  return s;
}

void sendState()
{
  ws.textAll( dataJson() );
  ssCnt = ee.rate;
}

// Check the buttons
void checkButtons()
{
#define BTN_CNT 4
  static bool bState[BTN_CNT];
  static bool bNewState[BTN_CNT];
  static bool lbState[BTN_CNT];
  static long debounce[BTN_CNT];
  static long lRepeatMillis;
  static bool bRepeat;

  static uint8_t buttons[] = {BTN_UP, BTN_DN, BTN_1, BTN_2};

#define REPEAT_DELAY 200 // increase for slower repeat

  for(int i = 0; i < BTN_CNT; i++)
  {
    bNewState[i] = digitalRead(buttons[i]);
    if(bNewState[i] != lbState[i])
      debounce[i] = millis(); // reset on state change

    bool bInvoke = false;
    if((millis() - debounce[i]) > 30)
    {
      if(bNewState[i] != bState[i]) // press or release
      {
        bState[i] = bNewState[i];
        if (bState[i] == LOW) // pressed
        {
          if(ee.bEnableOLED == false && displayOnTimer == 0) // skip first press with display off
          {
            bStartDisplay = true;
            displayOnTimer = 30;
          }else
            bInvoke = true;
          lRepeatMillis = millis(); // initial increment (doubled)
          bRepeat = false;
        }
      }
      else if(bState[i] == LOW) // holding down
      {
        if( (millis() - lRepeatMillis) > REPEAT_DELAY * (bRepeat?1:2) )
        {
          bInvoke = true;
          lRepeatMillis = millis();
          bRepeat = true;
        }
      }
    }

    if(bInvoke) switch(i)
    {
      case 0: // temp up
        if(ee.bVaca) // first tap, disable vacation mode
          ee.bVaca = false;
        else
          changeTemp(1, true);
        break;
      case 1: // temp down
        if(ee.bVaca) // disable vacation mode
          ee.bVaca = false;
        else
          changeTemp(-1, true);
        break;
      case 2: // right top button
//        if(displayOnTimer)
//          displayOnTimer = 0;
//        else
//          displayOnTimer = 30;
        break;
      case 3: // left top button
        ee.bEnableOLED = !ee.bEnableOLED;
        if(ee.bEnableOLED)
          bStartDisplay = true;
        displayOnTimer = 0;
        break;
    }
    lbState[i] = bNewState[i];
  }
}

void changeTemp(int delta, bool bAll)
{
  if(ee.bVaca) return;
  if(bAll)
  {
    for(int i = 0; i < ee.schedCnt; i++)
      ee.schedule[i].setTemp += delta;
  }
  else if(ee.bAvg) // bump both used in avg mode
  {
    ee.schedule[schInd].setTemp += delta;
    ee.schedule[ (schInd+1) % ee.schedCnt].setTemp += delta;
  }
  else
  {
    ee.schedule[schInd].setTemp += delta;    
  }
  checkLimits();
  checkSched(false);     // update temp
}

void checkLimits()
{
  for(int i = 0; i < ee.schedCnt; i++)
  {
    if(bCF)
      ee.schedule[i].setTemp = constrain(ee.schedule[i].setTemp, 160, 320); // sanity check (16~32c)
    else
      ee.schedule[i].setTemp = constrain(ee.schedule[i].setTemp, 600, 900); // sanity check (60~90)
    ee.schedule[i].thresh = constrain(ee.schedule[i].thresh, 1, 100); // (50~80)
  }
}

void checkSched(bool bUpdate)
{
  long timeNow = (hour()*60) + minute();

  if(bUpdate)
  {
    schInd = ee.schedCnt - 1;
    for(int i = 0; i < ee.schedCnt; i++) // any time check
      if(timeNow >= ee.schedule[i].timeSch && timeNow < ee.schedule[i+1].timeSch)
      {
        schInd = i;
        break;
      }
  }
  else for(int i = 0; i < ee.schedCnt; i++) // on-time check
  {
    if(timeNow == ee.schedule[i].timeSch)
    {
      schInd = i;
      break;
    }
  }

  hiTemp = ee.bVaca ? ee.vacaTemp : ee.schedule[schInd].setTemp;
  loTemp = ee.bVaca ? (hiTemp - 10) : (hiTemp - ee.schedule[schInd].thresh);
  int thresh = ee.schedule[schInd].thresh;

  if(!ee.bVaca && ee.bAvg) // averageing mode
  {
    int start = ee.schedule[schInd].timeSch;
    int range;
    int s2;

    // Find minute range between schedules
    if(schInd == ee.schedCnt - 1) // rollover
    {
      s2 = 0;
      range = ee.schedule[s2].timeSch + (24*60) - start;
    }
    else
    {
      s2 = schInd + 1;
      range = ee.schedule[s2].timeSch - start;
    }

    int m = (hour() * 60) + minute(); // current TOD in minutes

    if(m < start) // offset by start of current schedule
      m -= start - (24*60); // rollover
    else
      m -= start;

    hiTemp = tween(ee.schedule[schInd].setTemp, ee.schedule[s2].setTemp, m, range);
    thresh = tween(ee.schedule[schInd].thresh, ee.schedule[s2].thresh, m, range);
    loTemp = hiTemp - thresh;
  }
}

// avarge value at current minute between times
int tween(int t1, int t2, int m, int range)
{
  if(range == 0) range = 1; // div by zero check
  int t = (t2 - t1) * (m * 100 / range) / 100;
  return t + t1;
}

void Tone(unsigned int frequency, unsigned long duration)
{
  analogWriteFreq(frequency);
  analogWrite(TONE, 500);
  delay(duration);
  analogWrite(TONE,0);
}
