CuriousTech/WiFiWaterbedHeater/(commit log)

2015-10-30 Rev 1
    [HeaterCotrol.sch]
2015-11-02 Rev 1 buttons/screen aligned
    [HeaterControl.brd]
2015-11-06 Fixed backwards supply footprint
    [WaterbedSlave.brd]
2015-11-19 Heat low for non-PIC use
2015-11-19 Added jumper for auto-reset
    [HeaterCotrolPlusPIC.sch]
2015-12-08 Changed PPTC
    [WaterbedSlave.sch]
2015-12-08 Updated PPTC
    [WaterbedSlave.brd]
2015-12-18 Update for r2 board
2015-12-18 Updated for r2 board
    [HeaterCotrol.sch]
2016-01-09 Turns off if sensor isn't working
2016-01-17 Fixed tween, all good.
    [WiFiHeater.ino]
2016-05-08 Changed JSON names for use as HVAC remote sensor
2016-05-08 Extended IO0, IO2 to side
    [HeaterCotrol.sch]
2016-06-25 Fix password alert JSON
    [WiFiHeater.ino]
2016-09-14 startEvents() was missing, decimal place fix
    [WiFiHeater.ino]
2016-09-22 Switched to ESPAsyncWebServer
2016-12-15 Fixed remote message and beep
    [WiFiHeater.ino]
2017-03-09 Fixed array for the 24hr temps log
    [WiFiHeater.ino]
2017-04-05 Wrong month cost saved
    [WiFiHeater.ino]
2017-04-16 Updated to current web GUI
2017-07-06 Fix for printfAll bug
    [WiFiHeater.ino]
2017-09-21 3D print of control case
    [WB Control Back.stl, WB Control Front.stl]
2017-09-23 3D printed case for slave board
    [Slave Bottom.stl, Slave Top.stl]
2018-05-01 Removed more printfs, added room temp status
2018-05-17 Bugfix. cost[-1] memory error
    [WiFiHeater.ino]
2018-07-28 Slightly smaller old version
    [Slave Bottom.stl, Slave Top.stl]
2018-07-28 New cheap model
    [WaterbedSlave.brd, WaterbedSlave.sch]
2018-07-30 The cheap AC-DC sucked. Using trusted brand.
    [WaterbedSlave.brd, WaterbedSlave.sch]
2018-09-26 Simple 10A 3V relay version
    [WaterbedSlave.brd, WaterbedSlave.sch]
2018-09-26 Added i2c to side for Am2320
    [HeaterControl.brd, HeaterControl.sch]
2018-09-26 Backs up current cost sometimes
2018-10-13 Added top buttons
    [HeaterControl.brd, HeaterControl.sch]
2018-10-13 Top button model
    [Top_btn.stl, WBBack.stl, WBFront.stl]
2018-10-13 Removed a serial print
2018-10-13 Added buttons, raised vacation range
2018-10-15 Wider lower buttons
    [WBFront.stl, WBbutton.stl]
2019-05-15 Added eco switch
2019-05-15 Added eco mode (50% power)
2019-05-15 Added eco mode (50% power) <2.0F diff
2019-05-16 Added eco mode (50% power) <1.0F diff
2023-01-26 Switched to SmartConnect
